vChavezB/ZSWatch/(commit log)

2023-07-20 Initial hardware changes to add an external flash (AT25SL128A) to ZSwatch.
    [ZSWatch.kicad_pcb, ZSWatch.kicad_sch]
2023-07-28 Updated flash pcb design, with DRC rule fixes.
    - Lowered down silkscreen of ZWatch to add test points to SPI for testing.
    - Ground pad of flash is connected but is not necessary and can be removed
    to simplify connections.
    - Due to size constraints added 0402 resistors for pull up resistors on the left side
    of the flash.
    - Pending, change name of FLASH in Kicad to AT25SL128A.
    [ZSWatch.kicad_pcb, ZSWatch.kicad_sch]
2023-07-30 PCB: Tidy up some traces and vias for external flash feature.
    [ZSWatch.kicad_pcb]
2023-07-30 PCB: Move draft flash schematic into its own section. Correct datasheet and model number of flash.
    [ZSWatch.kicad_sch]
2023-07-31 Added workflow to build kicad diff pdf
    Workflo to build pdf of schematic and pcb with differences on pull request events.
2023-07-31 improved rules for kicad diff ci workflow
2023-12-01 test differences
    [ZSWatch.kicad_pcb, ZSWatch.kicad_sch]
